Nabizzle/Sensorized-Breakable-Block-and-DLC/Docs/Images/Circuit Diagram.png

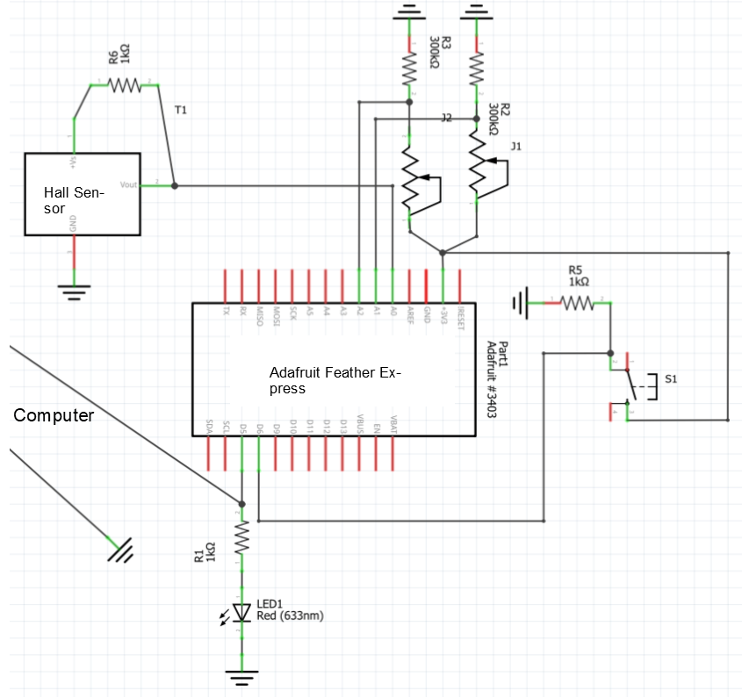
Docs/Images/Circuit Diagram.png
