Nabizzle/Sensorized-Breakable-Block-and-DLC/Docs/Images/DownloadStop.png

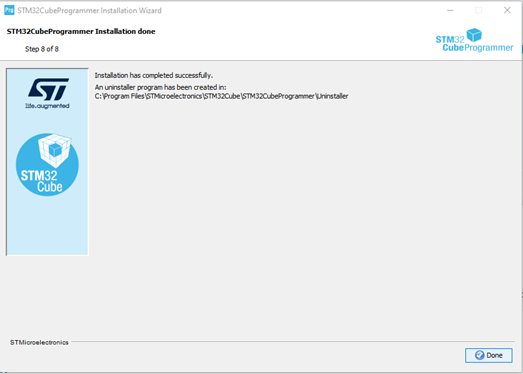
Docs/Images/DownloadStop.png
