Nabizzle/Sensorized-Breakable-Block-and-DLC/Docs/Images/PCBSide1.jpg

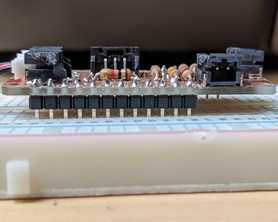
Docs/Images/PCBSide1.jpg
