Nabizzle/Sensorized-Breakable-Block-and-DLC/Docs/Images/PCBSide2.jpg

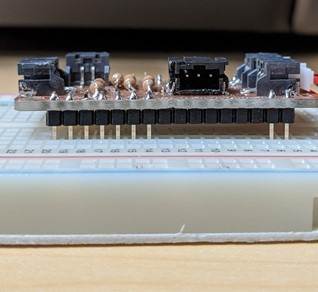
Docs/Images/PCBSide2.jpg
