Nabizzle/Sensorized-Breakable-Block-and-DLC/Docs/Images/PCBWithFeather.jpg

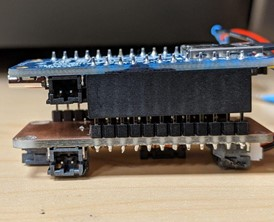
Docs/Images/PCBWithFeather.jpg
