Nabizzle/Sensorized-Breakable-Block-and-DLC/(commit log)

2021-07-26 Adds current working IMU data logging code
2021-07-29 feat: Adds the rest of the ReadMe
    Adds the rest of the current ReadMe based on the document that Susan and Patrick have prepared.
2021-08-05 Additonal Frame Refining image added to README
2021-08-11 Changed sample location to more relevent location
2021-08-11 Added sections to DLC Analysis: Calibration and Transferring
    -Also corrected DLC instructions where it alludes to parts 1-5, as these are no longer the labeling structure
    -other minor corrections for clarity in DLC analysis
2021-08-12 DLC Quick Reference Added
    Color coded for your convenience!
    Includes all DLC training steps, just in case
2021-08-12 Added instructions for DLC data calibration
2021-08-13 Added materials list for breakable box components
2021-08-13 Added to Library Setup on Arduino IDE
2021-08-13 Added pictures of the PCB
2021-08-13 Rewrote section titled Soldering Instructions
2021-08-13 Reformatted Materials List for BB
2021-08-13 Added comments to Arduino code
2021-08-13 Updated name of Arduino code file
2022-01-07 Update debug_Final_IMU.ino
    Multiple files can now be written on the microSD, in addition to LED sequences that indicate "states" of recording.
2022-06-10 Add files via upload
    This Arduino program reliably performs consecutive microSD card file creation and sensor recording for seamless transition from one breakable block test trial to another. In addition, the sensor rates have been modified to allow for a higher sampling rate.
